eatoin5hrdlu/Rendezvous/Doc/Rendezvous.odt

The 23-year-old exhibit “Rendezvous in Space” has been giving us trouble in the last few years, and it's barouque architecture and sketchy documentation discouraged us from digging deeply into its inner workings. For example, we've only found three or four pages of the so-called “re-calibration” procedure, with references to other unknown pages, and this convinced me that no living person could actually do the correct re-calibration.

When the very long lasting (automotive) belt failed, Frank Stephans contracted a specialty company to make five hand-spliced belts and pre-mount them around the central shaft avoiding for a few years what would turn out to be a catastrophic effects of dismantling the exhibit to its core (It's core, turns on two commutators, one with 12 wires and another with 6 that conduct up-to 2 amps of power into the rotating levels (shuttle =12, space-station =6).

All five belts failed in with increasing rapidity (probably due to the belts drying out) with the first belt lasting well over a year and the last belt failing within a month. Finally, iit was time to dismantle the “core” and put in a real automotive-grade fan belt. The brittle wires of the 12-conductor core broke during this operation and we replaced it with a new Moog unit ($500), but I was already envisioning a low-power, state-of-the-art, solution that could make the exhibit a kind of showcase of new technologies.

By replacing the high-current (shuttle) stepper motor (4 wires + 2Amp pulses) with a low-current DC motor with encoder (50mA running at full speed) and putting an Arduino micro-controller plus bluetooth receiver on the shuttle rotor reduced the power through the rotating commutator by more than a factor of 20 while giving us the flexibility of having a full-duplex serial communication between the main controller and the devices on the rotors. The bluetooth receiver on the shuttle rotor controls its up and down movements at different vertical speeds and monitors the limit switch and a (future) bluetooth reciever on the Space Station rotor could change lights under user control (even from a smartphone) or as the shuttle nears, detect the shuttle in docking, or other functions.

What do we mean by State of the Art?

The main controller is a Raspberry Pi ($35) with a bluetooth dongle ($4.95). On start-up it makes contact with the bluetooth controller ($3.00) on the Shuttle Rotor and directs it according to the user pushbuttons. It also interrogates the Shuttle controller (Arduino Mini-Pro $3.00) to get the actual altitude based on encoder on the DC 'altitude' motor. And uses this data to send the correct DC voltage to the Motor controllers (from the original Rendezvous in Space) for the orbital speed.

The use of current open-source computer systems (Raspberry Pi, Arduino), plus the latest in open-source sharing (Git) means that anyone interested in this exhibit can download the source and see exactly how it is working. With the Git program they can use the command:

“git clone https://github.com/eatoin5hrdlu/Rendezvous.git“

to get a copy of the source code and this document.

In addition to the new controllers, we were able to retro-fit the gears for the un-obtainable small drive belts and use the 3D printer to custom make gears that would be compatible with standard vacuum cleaner belts. It seemed quite appropriate to use a vacuum belt to repair our aerospace exhibit.

As a further example of transparent technology, the CAD files for these gears are in a readable geometric language called SCAD which can define a gear by specifying a cylinder with small rectangular shapes subtracted around the perimeter to form the teeth. This provides a simple demonstration of the connection between geometry and engineering. We were constrained by the distance between two shafts (which we couldn't change) and a small set of fixed length drive belts from the vacuum cleaner store, but we had flexiblity about the number of teeth on each of the two drive gears. These CAD files (as well as some intermediate designs) are also available in the Git archive.

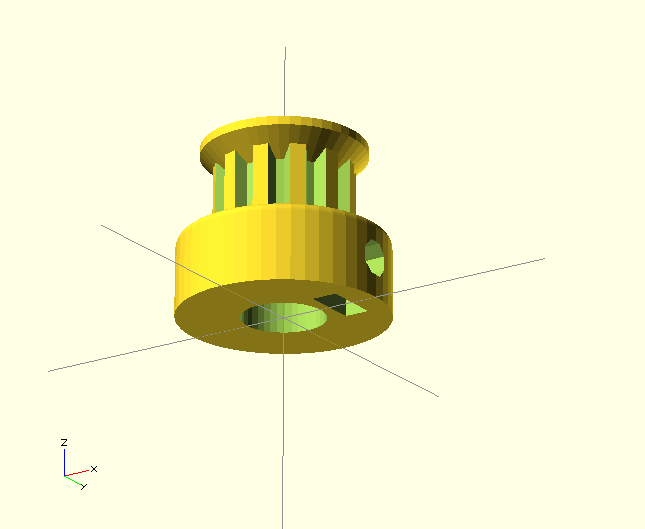
[picture p1: figure]

Large Pulley (10mmshaft)

// Belt pulley is http://www.thingiverse.com/thing:3104 by GilesBathgate

// GPLV3

// Made parametric by droftarts September 2011

// extra mods by triffid_hunter

/**

* @name Pulley

* @category Printed

* @using 1 x m3 nut, normal or nyloc

* @using 1 x m3x10 set screw or 1 x m3x8 grub screw

*/

module pulley()

{

// tuneable constants

m3_dia = 4.2; // 3mm hole diameter

m3_nut_hex = 1; // 1 for hex, 0 for square nut

m3_nut_flats = 6.5; // normal M3 hex nut exact width = 5.5

m3_nut_depth = 2.9; // normal M3 hex nut exact depth = 2.4, nyloc = 4

motor_shaft = 9.6; // NEMA17 motor shaft exact diameter = 5

retainer = 1; // Belt retainer end, 1 for Yes, 0 for No

idler = 0; // 0 = No, 1 = Yes; fills in dish of retainer, if required

retainer_ht = 4; // height of retainer flange over pulley, standard = 4. Indented into pulley by 2mm.

teeth = 12; // Number of teeth, standard Mendel = 8

tooth_width = 2.5; // width of base of tooth, exact size for T5 = 2.65, XL = 2.6124. Increase to improve fit.

tooth_angle = 60; // angle of tooth sides, exact angle for T5 = 40, XL = 50

tooth_height = 1.4; // height of tooth, exact size for T5 = 1.2, XL = 1.3 Increase to improve fit.

pulley_t_ht = 9; // length of toothed part of pulley, standard = 12

pulley_b_ht = 9; // 8 pulley base height, standard = 8

pulley_b_dia = 24; // pulley base diameter, standard = 20

no_of_nuts = 1; // number of captive nuts required, standard = 1

nut_angle = 90; // angle between nuts, standard = 90

nut_shaft_distance = 1.2; // distance between inner face of nut and shaft. standard = 1. Can be negative if your motor has D-shaft or filed flat. Do not set to zero or openscad will make a bad STL

// BELT SELECTION - uncomment preferred belt type

belt_type = "VAC";

teeth_dia = ((1.41 * pow(teeth,1.08)) / (0.84 + pow(teeth,1.08))) * teeth;

//belt_type = "T5";

//teeth_dia = ((1.591 * pow(teeth,1.064)) / (0.6523 + pow(teeth,1.064))) * teeth;

//belt_type = "XL";

//teeth_dia = ((1.617 * pow(teeth,1.021)) / (0.339 + pow(teeth,1.021))) * teeth;

echo (str("Belt type = ",belt_type,"; number of teeth = ",teeth,"; teeth diameter = ",teeth_dia,"mm"));

// calculated constants

nut_elevation = pulley_b_ht/2;

m3_nut_points = 2*((m3_nut_flats/2)/cos(30)); // This is needed for the nut trap

// Modules

module spur()

{

linear_extrude(height=pulley_t_ht+2) polygon([[0,-(tooth_width/2)],[0,(tooth_width/2)],[-tooth_height,((tooth_width/2)-(tan(tooth_angle/2)*tooth_height))],[-tooth_height,-((tooth_width/2)-(tan(tooth_angle/2)*tooth_height))]],[[0,1,2,3,0]]);

}

module retainer()

{

rotate_extrude($fn=teeth*4) translate([teeth_dia/2-2.5,0,0])

polygon([[0,0],[1,0],[retainer_ht , retainer_ht - 1],[retainer_ht , retainer_ht],[retainer_ht-2 , retainer_ht],[0,2]],[[0,1,2,3,4,5,0]]);

}

// Main

difference()

{

union()

{

//base

if ( pulley_b_ht < 2 ) { echo ("CAN'T DRAW PULLEY BASE, HEIGHT LESS THAN 2!!!"); } else {

rotate_extrude($fn=pulley_b_dia*2)

{

square([pulley_b_dia/2-1,pulley_b_ht]);

square([pulley_b_dia/2,pulley_b_ht-1]);

translate([pulley_b_dia/2-1,pulley_b_ht-1]) circle(1);

}

}

difference()

{

//shaft - diameter is outside diameter of pulley

translate([0,0,pulley_b_ht]) rotate ([0,0,360/(teeth*4)]) cylinder(r=teeth_dia/2,h=pulley_t_ht, $fn=teeth*2);

//teeth - cut out of shaft

for(i=[1:teeth]) rotate([0,0,i*(360/teeth)])

translate([teeth_dia/2,0,pulley_b_ht-1]) spur();

}

//belt retainer end

if ( retainer > 0 ) {translate ([0,0,pulley_b_ht + pulley_t_ht -2]) retainer();

if ( idler > 0 ) {translate ([0,0,pulley_b_ht + pulley_t_ht]) cylinder(r1=teeth_dia/2-1,r2=(teeth_dia/2-2) + (retainer_ht-2),h=retainer_ht-2,$fn=teeth*4);}}

}

//hole for motor shaft

translate([0,0,-1])cylinder(r=motor_shaft/2,h=pulley_b_ht + pulley_t_ht + (retainer_ht),$fn=motor_shaft*4);

//captive nut and grub screw holes

if ( pulley_b_ht < m3_nut_flats ) { echo ("CAN'T DRAW CAPTIVE NUTS, HEIGHT LESS THAN NUT DIAMETER!!!"); } else {

if ( (pulley_b_dia - motor_shaft)/2 < m3_nut_depth + 3 ) { echo ("CAN'T DRAW CAPTIVE NUTS, DIAMETER TOO SMALL FOR NUT DEPTH!!!"); } else {

for(j=[1:no_of_nuts]) rotate([0,0,j*nut_angle])

translate([0,0,nut_elevation])rotate([90,0,0])

union()

{

//entrance

translate([0,-pulley_b_ht/4-0.5,motor_shaft/2+m3_nut_depth/2+nut_shaft_distance]) cube([m3_nut_flats,pulley_b_ht/2+1,m3_nut_depth],center=true);

//nut

if ( m3_nut_hex > 0 )

{

// hex nut

translate([0,0.25,motor_shaft/2+m3_nut_depth/2+nut_shaft_distance]) rotate([0,0,30]) cylinder(r=m3_nut_points/2,h=m3_nut_depth,center=true,$fn=6);

} else {

// square nut

translate([0,0.25,motor_shaft/2+m3_nut_depth/2+nut_shaft_distance]) cube([m3_nut_flats,m3_nut_flats,m3_nut_depth],center=true);

}

//grub screw hole

rotate([0,0,22.5])cylinder(r=m3_dia/2,h=pulley_b_dia/2+1,$fn=8);

}

}}

}

}

pulley();

Small Pulley

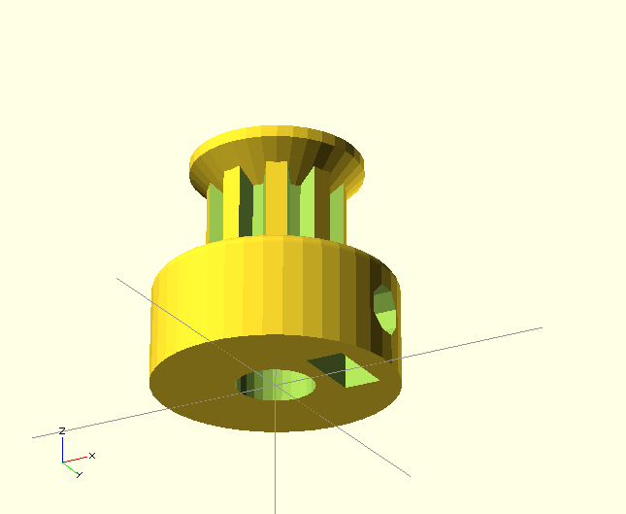
[picture p2: figure]

// Belt pulley is http://www.thingiverse.com/thing:3104 by GilesBathgate

// GPLV3

// Made parametric by droftarts September 2011

// extra mods by triffid_hunter

/**

* @name Pulley

* @category Printed

* @using 1 x m3 nut, normal or nyloc

* @using 1 x m3x10 set screw or 1 x m3x8 grub screw

*/

module pulley()

{

// tuneable constants

m3_dia = 4.2; // 3mm hole diameter

m3_nut_hex = 1; // 1 for hex, 0 for square nut

m3_nut_flats = 6.5; // normal M3 hex nut exact width = 5.5

m3_nut_depth = 3.2; // normal M3 hex nut exact depth = 2.4, nyloc = 4

motor_shaft = 6.6; // NEMA17 motor shaft exact diameter = 5

retainer = 1; // Belt retainer end, 1 for Yes, 0 for No

idler = 0; // 0 = No, 1 = Yes; fills in dish of retainer, if required

retainer_ht = 4; // height of retainer flange over pulley, standard = 4. Indented into pulley by 2mm.

teeth = 9; // Number of teeth, standard Mendel = 8

tooth_width = 2.5; // width of base of tooth, exact size for T5 = 2.65, XL = 2.6124. Increase to improve fit.

tooth_angle = 60; // angle of tooth sides, exact angle for T5 = 40, XL = 50

tooth_height = 1.4; // height of tooth, exact size for T5 = 1.2, XL = 1.3 Increase to improve fit.

pulley_t_ht = 9; // length of toothed part of pulley, standard = 12

pulley_b_ht = 9; // 8 pulley base height, standard = 8

pulley_b_dia = 20.6; // pulley base diameter, standard = 20

no_of_nuts = 1; // number of captive nuts required, standard = 1

nut_angle = 90; // angle between nuts, standard = 90

nut_shaft_distance = 1.4; // distance between inner face of nut and shaft. standard = 1. Can be negative if your motor has D-shaft or filed flat. Do not set to zero or openscad will make a bad STL

// BELT SELECTION - uncomment preferred belt type

belt_type = "VAC";

teeth_dia = ((1.41 * pow(teeth,1.08)) / (0.84 + pow(teeth,1.08))) * teeth;

//belt_type = "T5";

//teeth_dia = ((1.591 * pow(teeth,1.064)) / (0.6523 + pow(teeth,1.064))) * teeth;

//belt_type = "XL";

//teeth_dia = ((1.617 * pow(teeth,1.021)) / (0.339 + pow(teeth,1.021))) * teeth;

echo (str("Belt type = ",belt_type,"; number of teeth = ",teeth,"; teeth diameter = ",teeth_dia,"mm"));

// calculated constants

nut_elevation = pulley_b_ht/2;

m3_nut_points = 2*((m3_nut_flats/2)/cos(30)); // This is needed for the nut trap

// Modules

module spur()

{

linear_extrude(height=pulley_t_ht+2) polygon([[0,-(tooth_width/2)],[0,(tooth_width/2)],[-tooth_height,((tooth_width/2)-(tan(tooth_angle/2)*tooth_height))],[-tooth_height,-((tooth_width/2)-(tan(tooth_angle/2)*tooth_height))]],[[0,1,2,3,0]]);

}

module retainer()

{

rotate_extrude($fn=teeth*4) translate([teeth_dia/2-2.5,0,0])

polygon([[0,0],[1,0],[retainer_ht , retainer_ht - 1],[retainer_ht , retainer_ht],[retainer_ht-2 , retainer_ht],[0,2]],[[0,1,2,3,4,5,0]]);

}

// Main

difference()

{

union()

{

//base

if ( pulley_b_ht < 2 ) { echo ("CAN'T DRAW PULLEY BASE, HEIGHT LESS THAN 2!!!"); } else {

rotate_extrude($fn=pulley_b_dia*2)

{

square([pulley_b_dia/2-1,pulley_b_ht]);

square([pulley_b_dia/2,pulley_b_ht-1]);

translate([pulley_b_dia/2-1,pulley_b_ht-1]) circle(1);

}

}

difference()

{

//shaft - diameter is outside diameter of pulley

translate([0,0,pulley_b_ht]) rotate ([0,0,360/(teeth*4)]) cylinder(r=teeth_dia/2,h=pulley_t_ht, $fn=teeth*2);

//teeth - cut out of shaft

for(i=[1:teeth]) rotate([0,0,i*(360/teeth)])

translate([teeth_dia/2,0,pulley_b_ht-1]) spur();

}

//belt retainer end

if ( retainer > 0 ) {translate ([0,0,pulley_b_ht + pulley_t_ht -2]) retainer();

if ( idler > 0 ) {translate ([0,0,pulley_b_ht + pulley_t_ht]) cylinder(r1=teeth_dia/2-1,r2=(teeth_dia/2-2) + (retainer_ht-2),h=retainer_ht-2,$fn=teeth*4);}}

}

//hole for motor shaft

translate([0,0,-1])cylinder(r=motor_shaft/2,h=pulley_b_ht + pulley_t_ht + (retainer_ht),$fn=motor_shaft*4);

//captive nut and grub screw holes

if ( pulley_b_ht < m3_nut_flats ) { echo ("CAN'T DRAW CAPTIVE NUTS, HEIGHT LESS THAN NUT DIAMETER!!!"); } else {

if ( (pulley_b_dia - motor_shaft)/2 < m3_nut_depth + 3 ) { echo ("CAN'T DRAW CAPTIVE NUTS, DIAMETER TOO SMALL FOR NUT DEPTH!!!"); } else {

for(j=[1:no_of_nuts]) rotate([0,0,j*nut_angle])

translate([0,0,nut_elevation])rotate([90,0,0])

union()

{

//entrance

translate([0,-pulley_b_ht/4-0.5,motor_shaft/2+m3_nut_depth/2+nut_shaft_distance]) cube([m3_nut_flats,pulley_b_ht/2+1,m3_nut_depth],center=true);

//nut

if ( m3_nut_hex > 0 )

{

// hex nut

translate([0,0.25,motor_shaft/2+m3_nut_depth/2+nut_shaft_distance]) rotate([0,0,30]) cylinder(r=m3_nut_points/2,h=m3_nut_depth,center=true,$fn=6);

} else {

// square nut

translate([0,0.25,motor_shaft/2+m3_nut_depth/2+nut_shaft_distance]) cube([m3_nut_flats,m3_nut_flats,m3_nut_depth],center=true);

}

//grub screw hole

rotate([0,0,22.5])cylinder(r=m3_dia/2,h=pulley_b_dia/2+1,$fn=8);

}

}}

}

}

pulley();

Arduino Code:

// Using dual 2Amp motor driver DFRobot part # DR10002

// A and B are coils on Shuttle Altitude stepper motor

// MA(MB) enables the A(B) Coil and DA(DB) sets polarity

//

// Two analog voltages out (using PWM) on pins 3 and 9

// adjust the speeds of the Space Station and Shuttle resp.

//

// Space station speed is constant and slow

// Shuttle speed is inversely proportional to altitude

// and set to match Station velocity at the same altitude.

//

// Pin assignment

#define DA 7

#define MA 8

#define DB 5

#define MB 6

#define CW 10 // Forward

#define CCW 11 // Reverse

#define LOW_LIMIT_SWITCH 12 // Limit switch

#define STATION 3

#define SHUTTLE 9

#define VOLTS_TO_PWM(v) ( int ((v*255.0)/4.86) )

#define speed(p,v) analogWrite(p,VOLTS_TO_PWM(v))

#define NUM_SPEEDS 20

double speeds[NUM_SPEEDS] = {1.20,1.25,1.30,1.40,1.50,1.65,1.80,2.00,2.20,2.30,

2.40,2.45,2.55,2.60,2.70,2.80,2.90,3.00,3.05,3.10};

int stationspeed;

int shuttlespeed;

int cntr;

#define MAX_HEIGHT 9000 // Don't go higher than this

int height;

boolean toggle;

// If we always stop as A -> 0 (and all other settings are zero)

// and and always start with A -> 1 (when all other settings are zero)

// there will be no gliches in the phase.

#define STEPS 8

#define REV(s) (s+1)%STEPS

const int dir_pin[STEPS] = {DA, DB, DB, DA, DA, DB, DB, DA };

const int dir_value[STEPS] = { 0, 1, 0, 0, 1, 0, 1, 1 };

const int enable_pin[STEPS] = {MA, MB, MB, MA, MA, MB, MB, MA };

const int enable_value[STEPS]= { 1, 0, 1, 0, 1, 0, 1, 0 };

void MOTOR(int i) {

digitalWrite(dir_pin[i],dir_value[i]);

digitalWrite(enable_pin[i],enable_value[i]);

//Serial.print(dir_pin[i]);Serial.print(" "),Serial.println(enable_pin[i]);

delay(2);

}

// Forward keeps track of the shuttle height

void forward(int count) {

Serial.println("forward");

while(count-- and height < MAX_HEIGHT) {

for(int i=STEPS-1; i>-1; i--) MOTOR(REV(i));

height += 1;

}

// digitalWrite(DB,1);

digitalWrite(MB,0);

digitalWrite(MA,0);

}

// Reverse checks the lower limit switch (and adjusts the height value)

void reverse(int count) {

Serial.println("reverse");

while(count-- and digitalRead(LOW_LIMIT_SWITCH) ) {

for(int i=0; i<STEPS; i++) MOTOR(i);

if (height > 0) height -= 1;

}

// digitalWrite(DA,1);

digitalWrite(MA,0);

digitalWrite(MB,0);

}

void flashLed () {

// Turn the led on and off

digitalWrite(LED_BUILTIN,toggle);

toggle = !toggle;

}

void setup() {

Serial.begin(9600);

for (int i=2; i<6; i++) {

pinMode(i,OUTPUT);

digitalWrite(i,0);

}

pinMode(LED_BUILTIN,OUTPUT);

toggle = true;

pinMode(CW, INPUT_PULLUP);

pinMode(CCW, INPUT_PULLUP);

pinMode(LOW_LIMIT_SWITCH,INPUT_PULLUP);

// Reverse the motor until it triggers the limit switch

Serial.print("LLSW ");

Serial.println(digitalRead(LOW_LIMIT_SWITCH));

while (digitalRead(LOW_LIMIT_SWITCH)) {

Serial.println("reversing");

reverse(20);

delay(1);

}

height = 0;

cntr = 0;

shuttlespeed = 0;

stationspeed = 19;

speed(SHUTTLE, 1.3);

Serial.println(VOLTS_TO_PWM(1.3));

speed(STATION, 2.4);

Serial.println(VOLTS_TO_PWM(2.4));

Serial.println(VOLTS_TO_PWM(3.0));

}

void loop() {

delay(1);

// flashLed();

// Rotate the motor when a single button is pressed

if (digitalRead(CCW) and !digitalRead(CW)) reverse(20);

if (!digitalRead(CCW) and digitalRead(CW)) forward(20);

if ((cntr++ % 5000) == 0)

Serial.println(height);

}

In what follows, the commands are in monospace font.

To set up a Raspberry Pi as a Bluetooth host:

apt-get install bluez-utils bluez-tools blueman libbluetooth-dev

Then:

hciconfig

will give you the hci device number (say hci0) and

hcitool scan

will show you available bluetooth devices

If hcitool scan produces : 98:D3:31:30:2A:D1

then:

bluez-simple-agent hci0 98:D3:31:30:2A:D1

will allow you to pair with that device.

Using the command line instead of blueman-manager(GUI) allows you to set this up on an IPE (blackout proof) version of raspian.

Once your software is installed and tested, you type:

ipe-ro

And the root file system becomes read-only, protecting your SD file system from power outages.

Rendezvous in Space Redux
