eatoin5hrdlu/Rendezvous/Doc/L298N.png

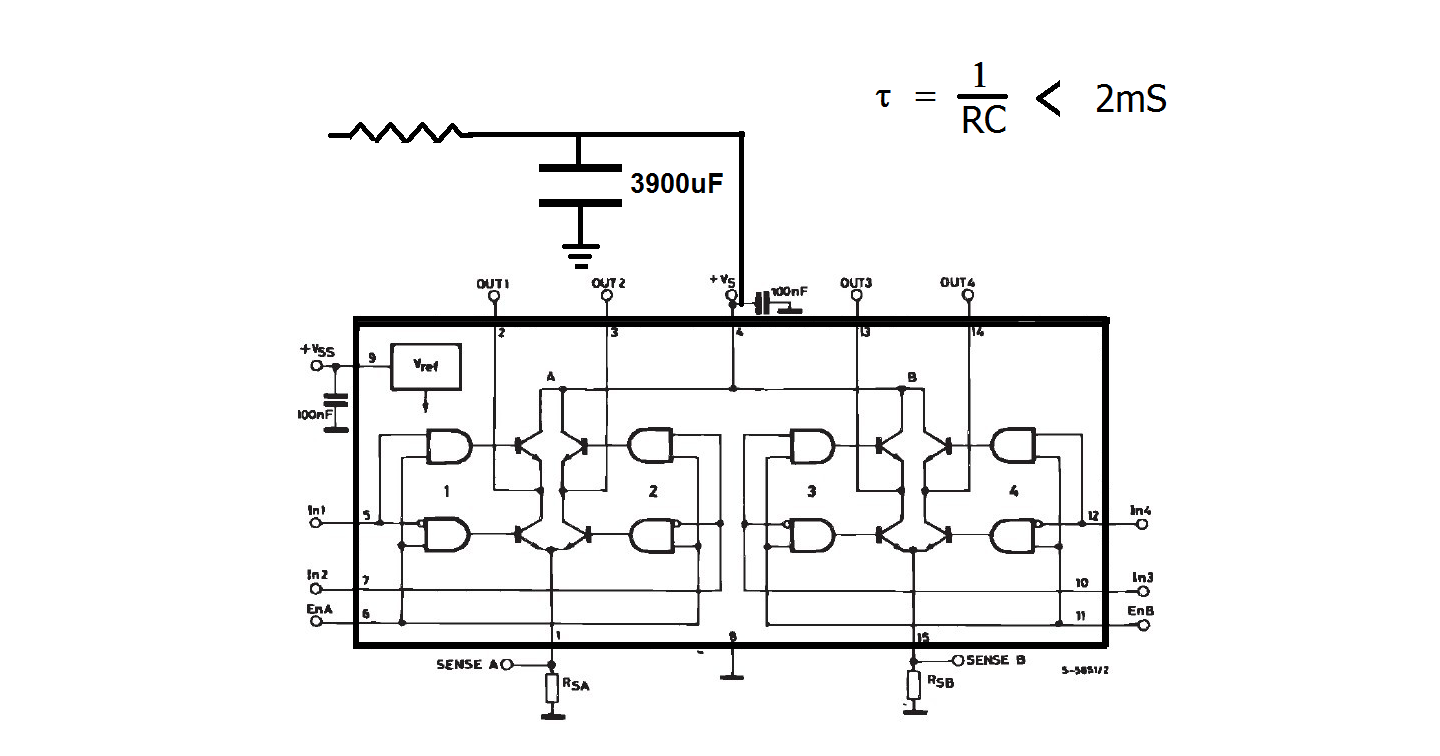
Doc/L298N.png
