eatoin5hrdlu/Rendezvous/(commit log)

2015-03-25 last chance for wiringPi - got rid of .git file
2015-04-01 added socket timeout and reset after comm loss
    [rendezvous.cpp]
